jesseseay/kicad_lib/template/Hammond_1593K_Enclosure/meta/1593K3B.jpg

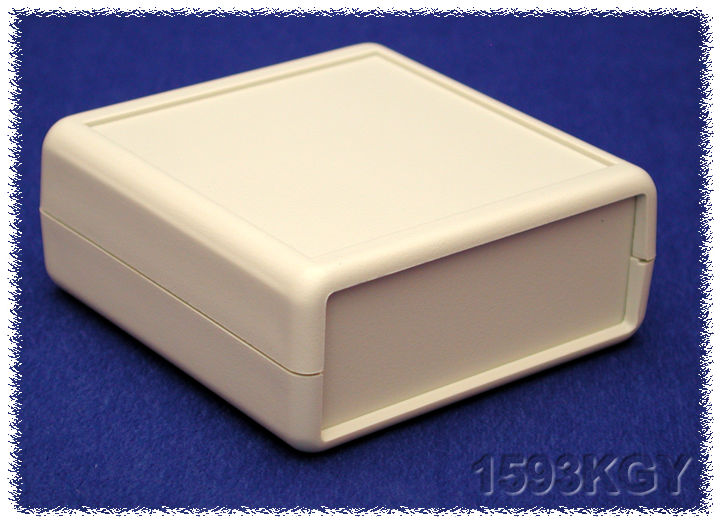
template/Hammond_1593K_Enclosure/meta/1593K3B.jpg
