jesseseay/kicad_lib/template/stm32f100-discovery-shield/meta/board_stm32vl_discovery.png

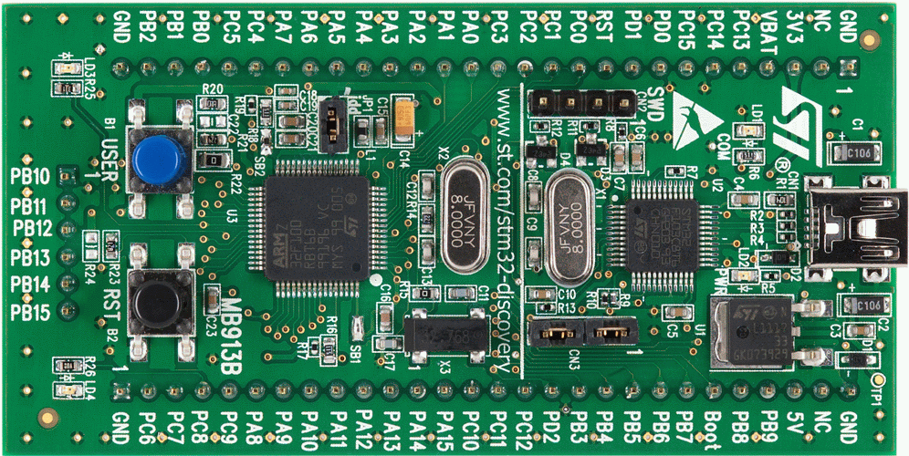
template/stm32f100-discovery-shield/meta/board_stm32vl_discovery.png
