jesseseay/kicad_lib/template/Arduino_Fio/meta/brd.png

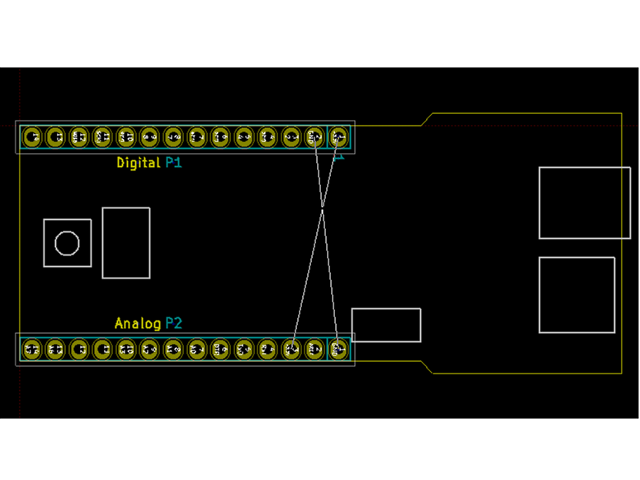
template/Arduino_Fio/meta/brd.png
