jesseseay/kicad_lib/template/Arduino_Mega_R3/meta/brd.png

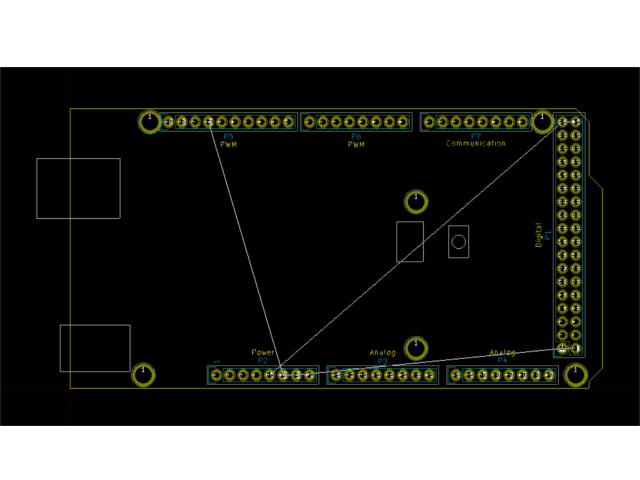
template/Arduino_Mega_R3/meta/brd.png
