jesseseay/kicad_lib/template/Arduino_Micro/meta/brd.png

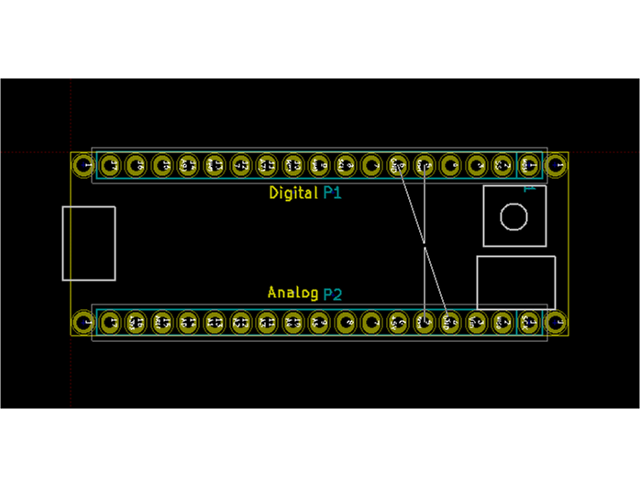
template/Arduino_Micro/meta/brd.png
