jesseseay/kicad_lib/template/Arduino_Mini/meta/brd.png

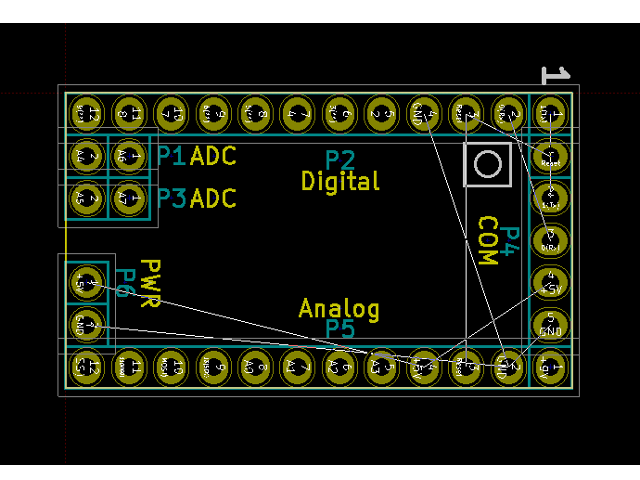
template/Arduino_Mini/meta/brd.png
