jesseseay/kicad_lib/template/Arduino_Nano/meta/brd.png

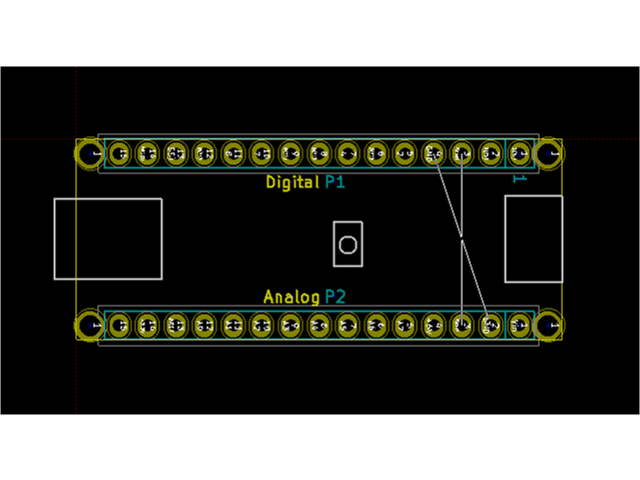
template/Arduino_Nano/meta/brd.png
