jesseseay/kicad_lib/template/Arduino_Pro_Mini/meta/brd.png

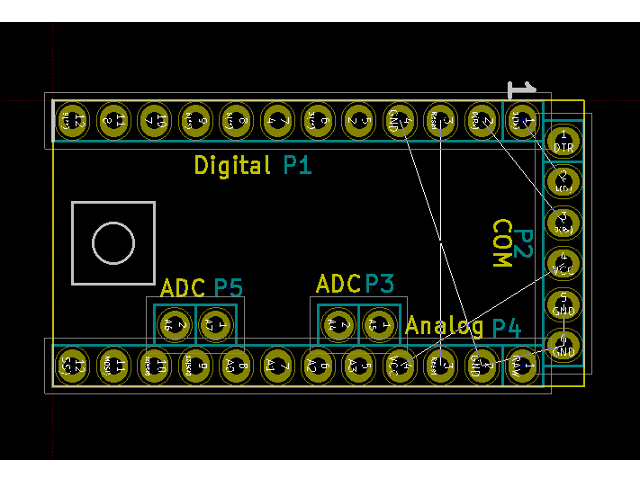
template/Arduino_Pro_Mini/meta/brd.png
