jesseseay/kicad_lib/template/BeagleBone-Black-Cape/meta/brd.png

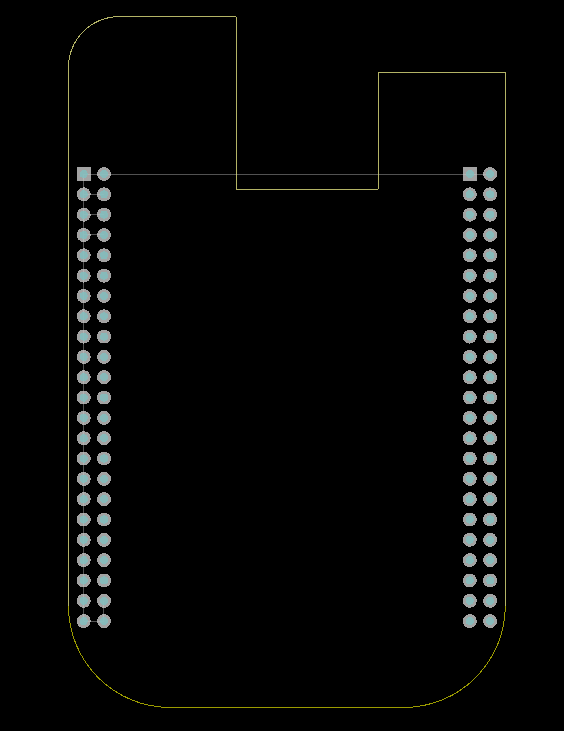
template/BeagleBone-Black-Cape/meta/brd.png
