jesseseay/kicad_lib/template/EuroCard160mmX100mm/meta/brd.png

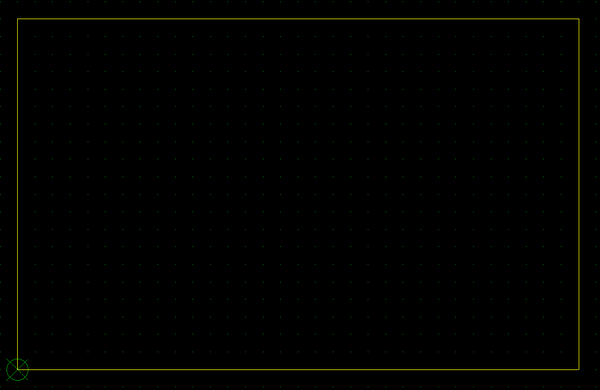
template/EuroCard160mmX100mm/meta/brd.png
