jesseseay/kicad_lib/template/Hammond_1593K_Enclosure/meta/brd.png

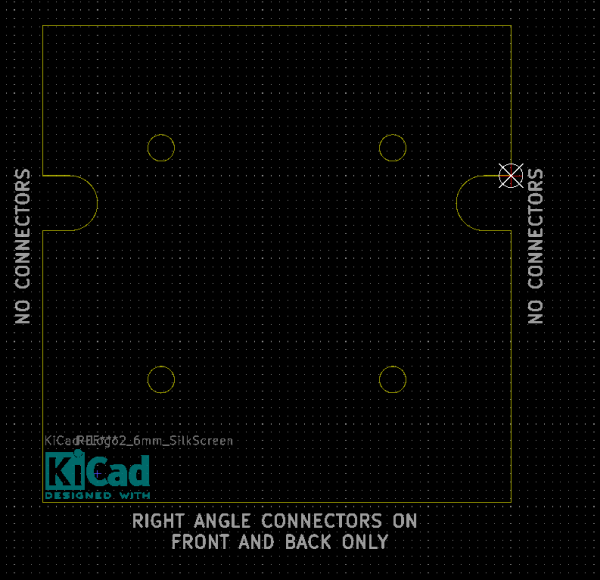
template/Hammond_1593K_Enclosure/meta/brd.png
