jesseseay/kicad_lib/template/minnowboard-ls-lure/meta/brd.png

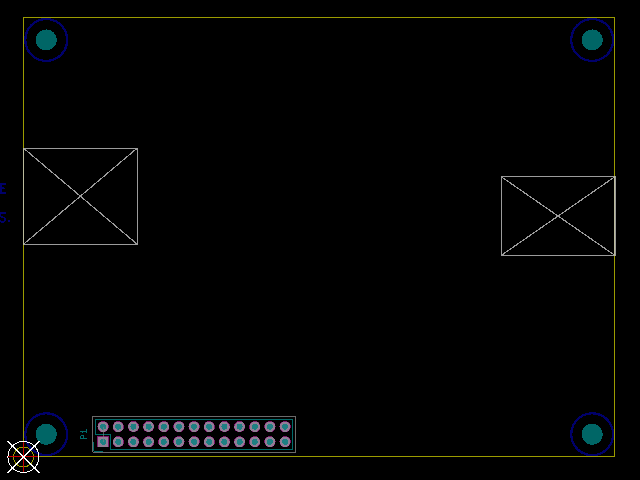
template/minnowboard-ls-lure/meta/brd.png
