jesseseay/kicad_lib/template/raspberrypi-gpio-40pin/meta/brd.png

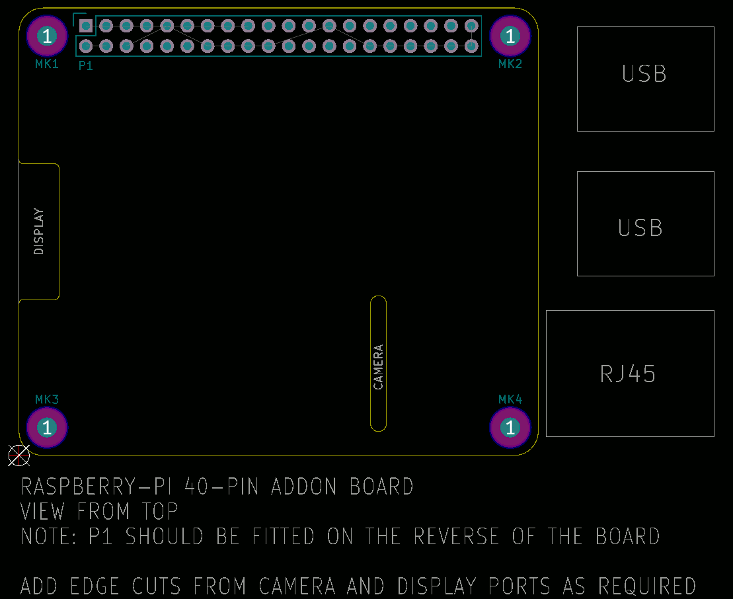
template/raspberrypi-gpio-40pin/meta/brd.png
