jesseseay/kicad_lib/template/raspberrypi-gpio/meta/brd.png

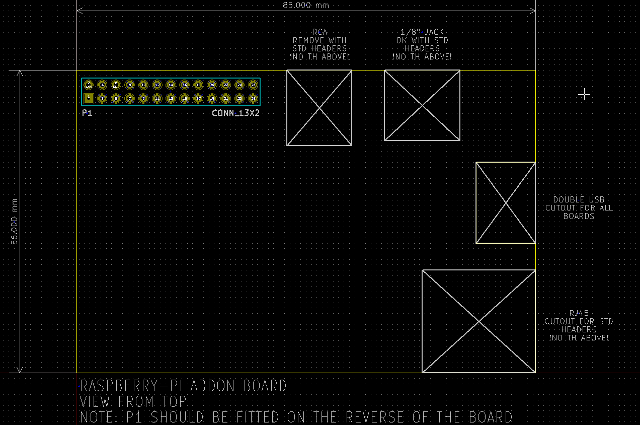
template/raspberrypi-gpio/meta/brd.png
