jesseseay/kicad_lib/template/raspberrypi_hat/meta/brd.png

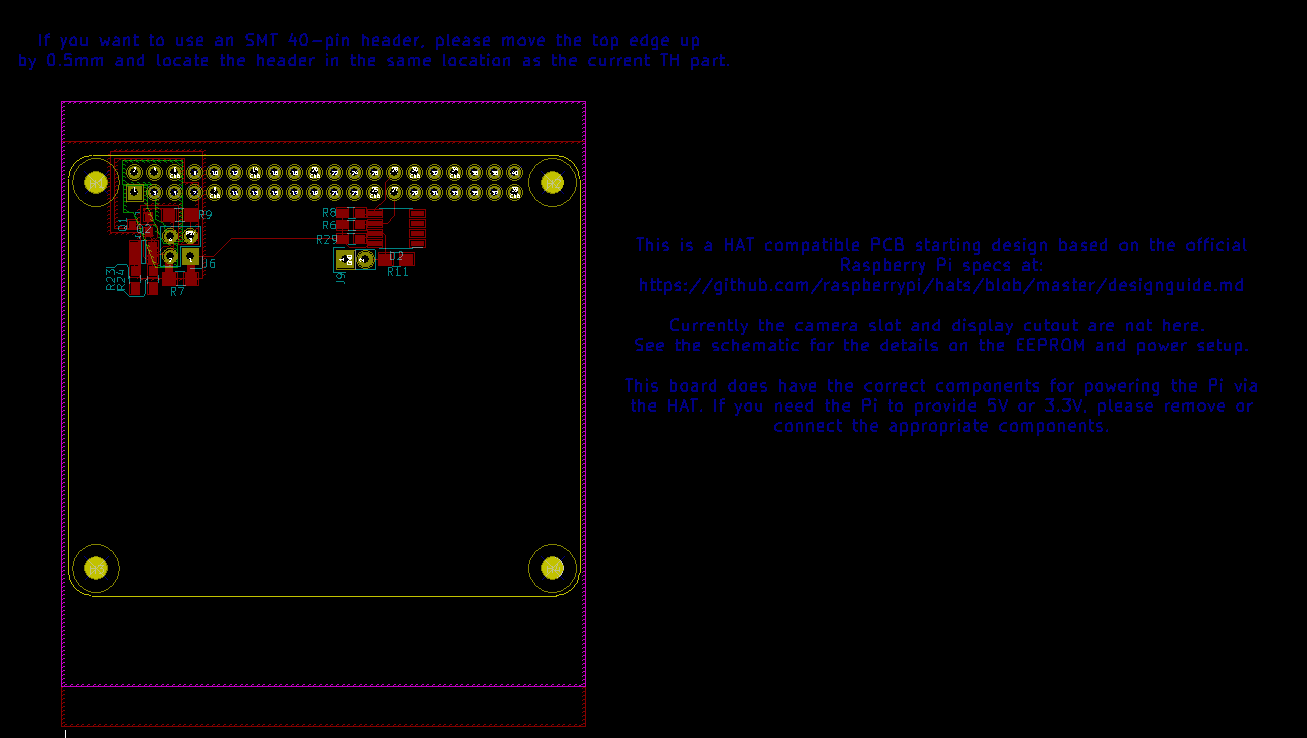
template/raspberrypi_hat/meta/brd.png
