jesseseay/kicad_lib/template/ti-stellaris-boosterpack40_min/meta/launchpad_standard40.png

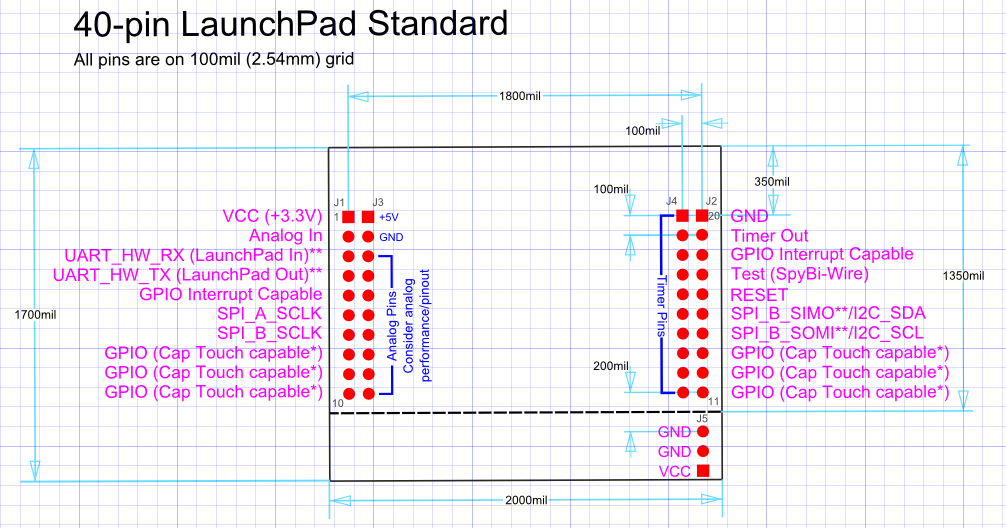
template/ti-stellaris-boosterpack40_min/meta/launchpad_standard40.png
