jesseseay/kicad_lib/Wingate kicad/demos/interf_u/tux.bmp

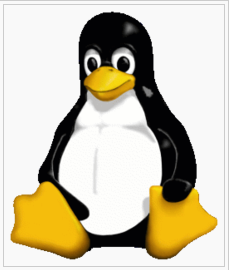
Wingate kicad/demos/interf_u/tux.bmp
