jesseseay/kicad_lib/Wingate kicad/demos/stickhub/3dmodels/APHB1608.step

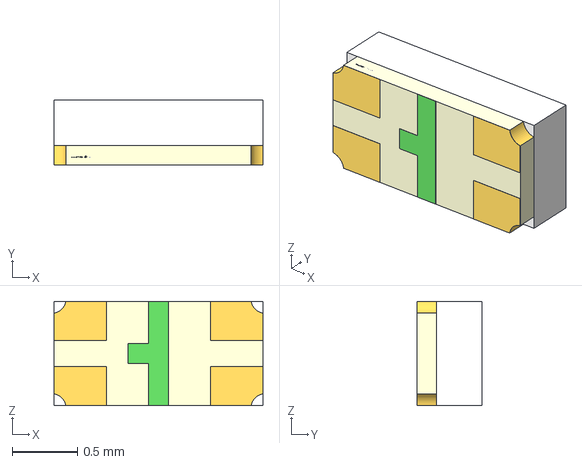
[picture p19: CAD file, 2022-09-02]
Wingate kicad/demos/stickhub/3dmodels/APHB1608.step
1.60 x 0.501 x 0.8 mm
