jesseseay/kicad_lib/Wingate kicad/demos/stickhub/3dmodels/TDFN-8_1.5x2mm_Fused-Lead_MO-252-W2015D.step

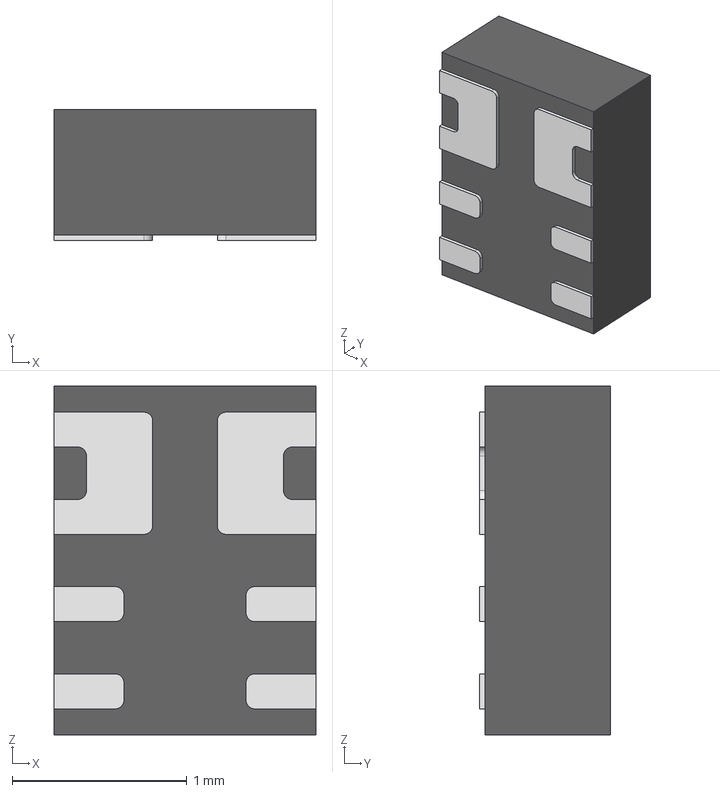
[picture p20: CAD file, 2022-09-02]
Wingate kicad/demos/stickhub/3dmodels/TDFN-8_1.5x2mm_Fused-Lead_MO-252-W2015D.step
1.50 x 0.75 x 2.00 mm
