jesseseay/kicad_lib/Wingate kicad/demos/stickhub/3dmodels/Crystal_SMD_4P_2520.step

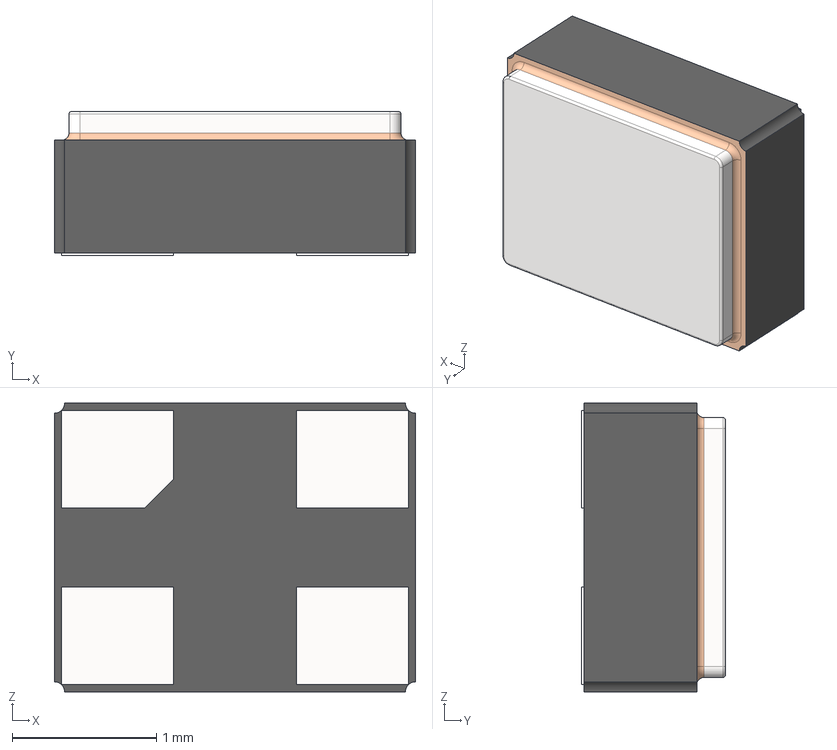
[picture p21: CAD file, 2022-09-02]
Wingate kicad/demos/stickhub/3dmodels/Crystal_SMD_4P_2520.step
2.50 x 1.00 x 2.00 mm
