jesseseay/kicad_lib/Wingate kicad/demos/stickhub/3dmodels/JST_SH_SM04B-SRSS-TB.STEP

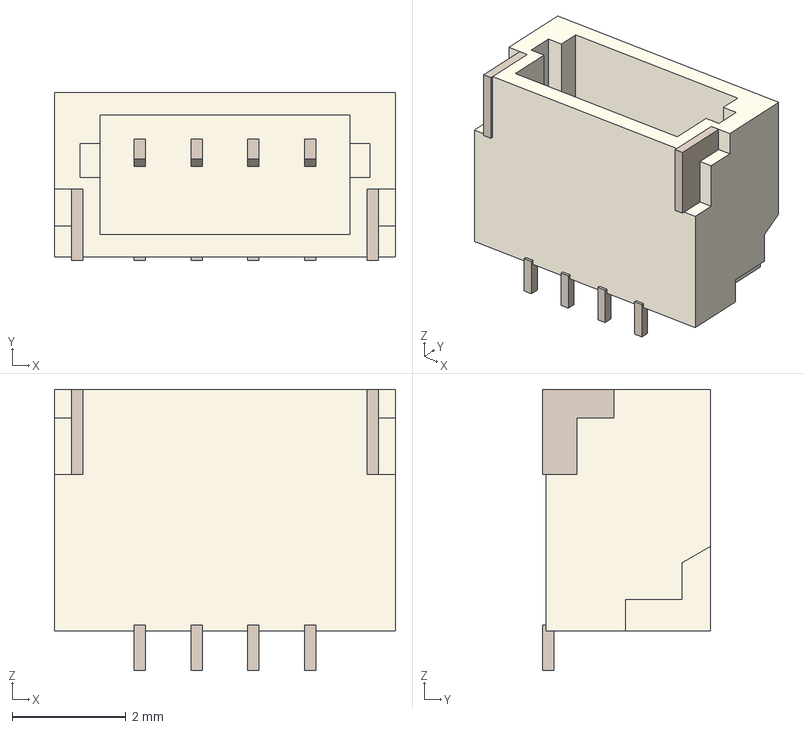
[picture p22: CAD file, 2022-09-02]
Wingate kicad/demos/stickhub/3dmodels/JST_SH_SM04B-SRSS-TB.STEP
6.00 x 2.96 x 4.95 mm
