jesseseay/kicad_lib/Wingate kicad/demos/stickhub/StickHub.kicad_pcb

## KiCad design Wingate kicad/demos/stickhub/StickHub.kicad_pcb (2022-09-02)

Schematic: StickHub.kicad_sch

Parts:
C1: 1uF 10V; 1608_C; Voltage 16V; Tolerance 10%; MPN FS15B105K100PKG
C2, C5, C6, C7, C8, C9, C10, C11, C12, C13: 0.1uF; 1608_C; Voltage 16V; Tolerance 10%; MPN CC0402KRX7R7BB104
C3, C4: 10uF 6.3V; 1608_C; Voltage 16V; Tolerance 10%; MPN CL05A106MQ5NUNC
C14, C15, C16, C17, C18, C19, C20, C21: 0.1uF 100V; 1608_C; Voltage 16V; Tolerance 10%; MPN NM0805B104K101CEDN
C22, C23, C24, C25, C26, C27, C29, C30, C31, C32, C33, C34, C35, C36, C37: 22uF 10V; 1608_C; Voltage 16V; Tolerance 10%; MPN GRM188R61A226ME15D
C28: 15nF; 1608_C; Voltage 16V; Tolerance 10%
C38: 330uF 10V; CP_Elec_6.3x7.7
D1, D2, D3, D4, D5, D6, D7, D8, D9, D10, D11, D12, D13, D14, D22, D23: TVS; 1006_C; MPN AR0521P1
D15, D16, D17, D18, D19, D20, D21: USB; Duo_LED_1.6x0.8_Kingbright_APHB1608LZGKSURKC; MPN APHB1608SGEC
D24, D25: 5V; 1006_C; MPN D5V0H1B2LP-7B
H1: Strap; Plain_Hole_3mm
J1: HOST; USB_A_PCB_traces_small
J2: USB1; JST_SH_SM04B-SRSS-TB_1x04-1MP_P1.00mm_Horizontal; MPN SM04B-SRSS-TB(LF)(SN)
J3: USB2; JST_SH_SM04B-SRSS-TB_1x04-1MP_P1.00mm_Horizontal; MPN SM04B-SRSS-TB(LF)(SN)
J4: USB3; JST_SH_SM04B-SRSS-TB_1x04-1MP_P1.00mm_Horizontal; MPN SM04B-SRSS-TB(LF)(SN)
J5: USB4; JST_SH_SM04B-SRSS-TB_1x04-1MP_P1.00mm_Horizontal; MPN SM04B-SRSS-TB(LF)(SN)
J6: USB5; JST_SH_SM04B-SRSS-TB_1x04-1MP_P1.00mm_Horizontal; MPN SM04B-SRSS-TB(LF)(SN)
J7: USB6; JST_SH_SM04B-SRSS-TB_1x04-1MP_P1.00mm_Horizontal; MPN SM04B-SRSS-TB(LF)(SN)
J8: USB7; JST_SH_SM04B-SRSS-TB_1x04-1MP_P1.00mm_Horizontal; MPN SM04B-SRSS-TB(LF)(SN)
J9: EXTGND; 1P-1.5x1.5
JP1: EXTPWR; PinHeader_1x02_P2.54mm_Vertical
LOGO1, LOGO2, LOGO3, LOGO4: Logo
R1: 10k; 1608_C; MPN 0402WGF1002TCE
R2, R3, R4, R5: 100k; 1608_C; MPN 0402WGF1003TCE
R6: 2.7k; 1608_C; MPN 0402WGF2701TCE
R7, R8, R9, R10, R11, R12, R13: 470; 1608_C; MPN 0402WGF4700TCE
U1: MaxLinear_XR22417-48; LQFP-48_7x7mm_P0.5mm; MPN XR22417CV48TR-F
U2: Dialog_SLG5NT1487V; TDFN-8_1.5x2mm_Fused-Lead_JEDEC_MO-252_W2015D; MPN SLG5NT1487VTR
Y1: 12MHz 50ppm 16-20pF; Crystal_4-SMD_2.5x2mm; MPN CM4012M00020T8188026

Connections:
+1V8: C4.1, C11.1, C12.1, C13.1, U1.6 (VCC18), U1.21 (VCC18), U1.25 (1V8_OUT), U1.28 (VCC18)
+3V3: C3.1, C5.1, C6.1, C7.1, C8.1, C9.1, C10.1, R3.1, R4.1, R5.1, U1.9 (3V3_OUT), U1.15 (VCC33), U1.20 (VCC33), U1.26 (VCC33), U1.31 (VCC33), U1.36 (VCC33), U1.42 (VCC33)
+5V: C1.1, C14.1, C15.1, C16.1, C17.1, C18.1, C19.1, C20.1, C22.1, C23.1, C24.1, C25.1, C26.1, C27.1, C29.1, C30.1, C31.1, C32.1, C33.1, C34.1, C35.1, C36.1, C37.1, C38.1 (+), D25.2 (A2), J2.1, J3.1, J4.1, J5.1, J6.1, J7.1, J8.1, R1.1, U1.8 (VCC5), U2.5 (S)
/D+: D23.2 (A2), J1.3, U1.30 (UP_D+)
/D-: D22.2 (A2), J1.2, U1.29 (UP_D-)
/LC: D15.GK (2), D15.RA (3), D16.GK (2), D16.RA (3), D17.GK (2), D17.RA (3), D18.GK (2), D18.RA (3), D19.GK (2), D19.RA (3), D20.GK (2), D20.RA (3), D21.GK (2), D21.RA (3), U1.1 (LED_CTL)
/LED1: R7.2, U1.3 (LED1/SCL)
/LED2: R8.2, U1.4 (LED2)
/LED3: R9.2, U1.5 (LED3)
/LED4: R10.2, U1.7 (LED4)
/LED5: R11.2, U1.48 (LED5)
/LED6: R12.2, U1.47 (LED6)
/LED7: R13.2, U1.46 (LED7)
/U1D+: D2.2 (A2), J2.3, U1.19 (USB1D+)
/U1D-: D1.2 (A2), J2.2, U1.18 (USB1D-)
/U2D+: D4.2 (A2), J3.3, U1.17 (USB2D+)
/U2D-: D3.2 (A2), J3.2, U1.16 (USB2D-)
/U3D+: D6.2 (A2), J4.3, U1.14 (USB3D+)
/U3D-: D5.2 (A2), J4.2, U1.13 (USB3D-)
/U4D+: D8.2 (A2), J5.3, U1.12 (USB4D+)
/U4D-: D7.2 (A2), J5.2, U1.11 (USB4D-)
/U5D+: D10.2 (A2), J6.3, U1.33 (USB5D+)
/U5D-: D9.2 (A2), J6.2, U1.32 (USB5D-)
/U6D+: D12.2 (A2), J7.3, U1.35 (USB6D+)
/U6D-: D11.2 (A2), J7.2, U1.34 (USB6D-)
/U7D+: D14.2 (A2), J8.3, U1.38 (USB7D+)
/U7D-: D13.2 (A2), J8.2, U1.37 (USB7D-)
/XI: U1.22 (XTALIN), Y1.1
/XO: U1.23 (XTALOUT), Y1.3
GND: C1.2, C2.2, C3.2, C4.2, C5.2, C6.2, C7.2, C8.2, C9.2, C10.2, C11.2, C12.2, C13.2, C14.2, C15.2, C16.2, C17.2, C18.2, C19.2, C20.2, C21.2, C22.2, C23.2, C24.2, C25.2, C26.2, C27.2, C28.2, C29.2, C30.2, C31.2, C32.2, C33.2, C34.2, C35.2, C36.2, C37.2, C38.2 (-), D1.1 (A1), D2.1 (A1), D3.1 (A1), D4.1 (A1), D5.1 (A1), D6.1 (A1), D7.1 (A1), D8.1 (A1), D9.1 (A1), D10.1 (A1), D11.1 (A1), D12.1 (A1), D13.1 (A1), D14.1 (A1), D22.1 (A1), D23.1 (A1), D24.1 (A1), D25.1 (A1), J1.4, J2.4, J2.MP (MountPin), J3.4, J3.MP (MountPin), J4.4, J4.MP (MountPin), J5.4, J5.MP (MountPin), J6.4, J6.MP (MountPin), J7.4, J7.MP (MountPin), J8.4, J8.MP (MountPin), J9.1, R2.2, R6.2, U1.10 (GND), U1.24 (GND), U1.39 (GND), U2.8 (GND), Y1.2 (GND), Y1.4 (GND)
unnamed: C2.1, R1.2, R2.1, U1.41 (VBUS_SENSE)
unnamed: C28.1, U2.7 (CAP)
unnamed: D15.GA (1), D15.RK (4), R7.1
unnamed: D16.GA (1), D16.RK (4), R8.1
unnamed: D17.GA (1), D17.RK (4), R9.1
unnamed: D18.GA (1), D18.RK (4), R10.1
unnamed: D19.GA (1), D19.RK (4), R11.1
unnamed: D20.GA (1), D20.RK (4), R12.1
unnamed: D21.GA (1), D21.RK (4), R13.1
unnamed: J1.1, JP1.1
unnamed: R3.2, U1.40 (EXT_RST#)
unnamed: R4.2, U1.45 (TEST3#)
unnamed: R5.2, U1.43 (TEST1#)
unnamed: R6.1, U1.27 (REXT)
VIN: C21.1, D24.2 (A2), JP1.2, U2.1 (VDD), U2.2 (ON), U2.3 (D)

Notes on the sheet:
ESD caps at connectors / plug
Shared VBUS capacitance

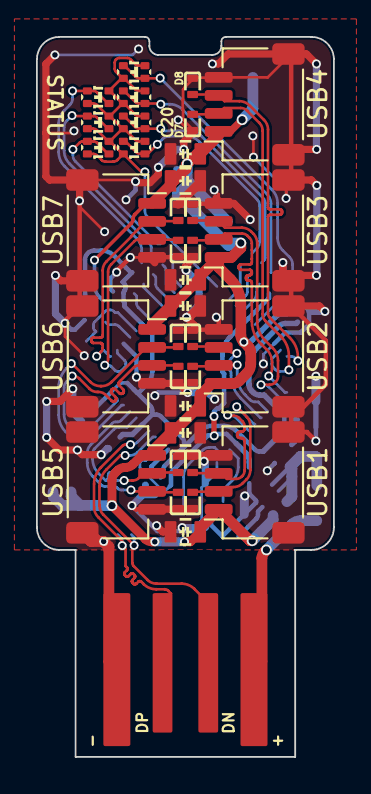
[picture p28: board StickHub.kicad_pcb from above]

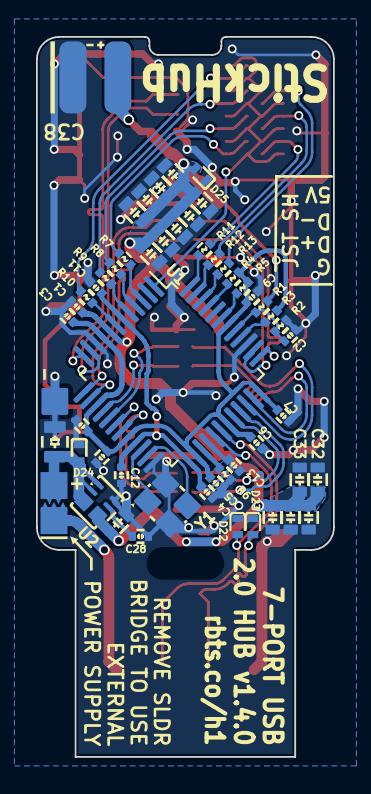
[picture p29: board StickHub.kicad_pcb from below]

Board: 2 copper layers, 16.5 x 40.0 mm, 94 parts (57 on the bottom side), 45 nets.
