jesseseay/kicad_lib/Wingate kicad/demos/test_xil_95108/carte_test.kicad_pcb

## KiCad design Wingate kicad/demos/test_xil_95108/carte_test.kicad_pcb (2022-09-02)

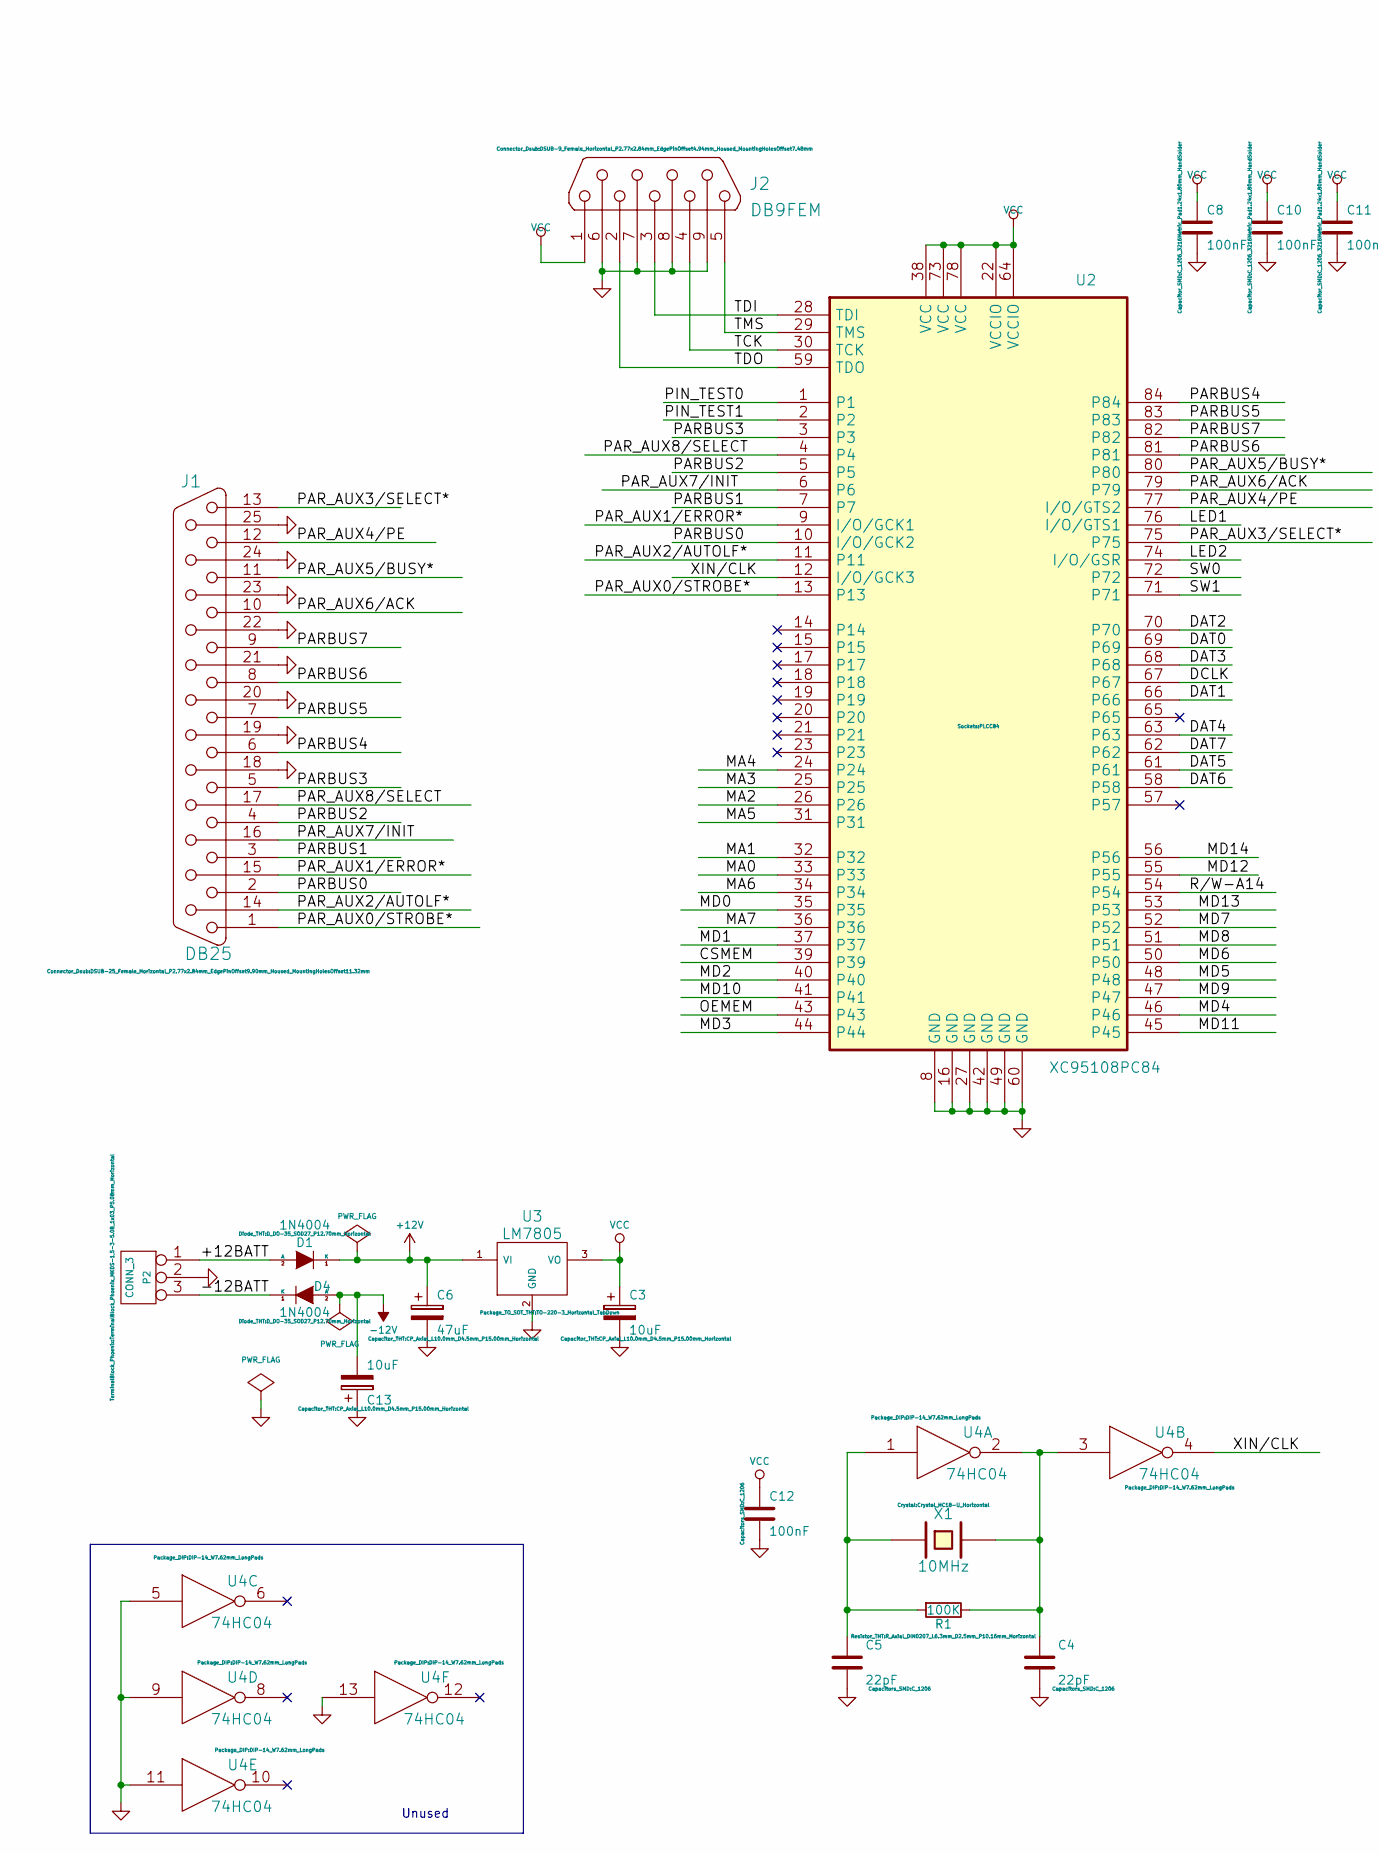
[picture p30: schematic carte_test.kicad_sch, XC95108PC84 EXPERIMENTATION BOARD, part in row 1, column 1]

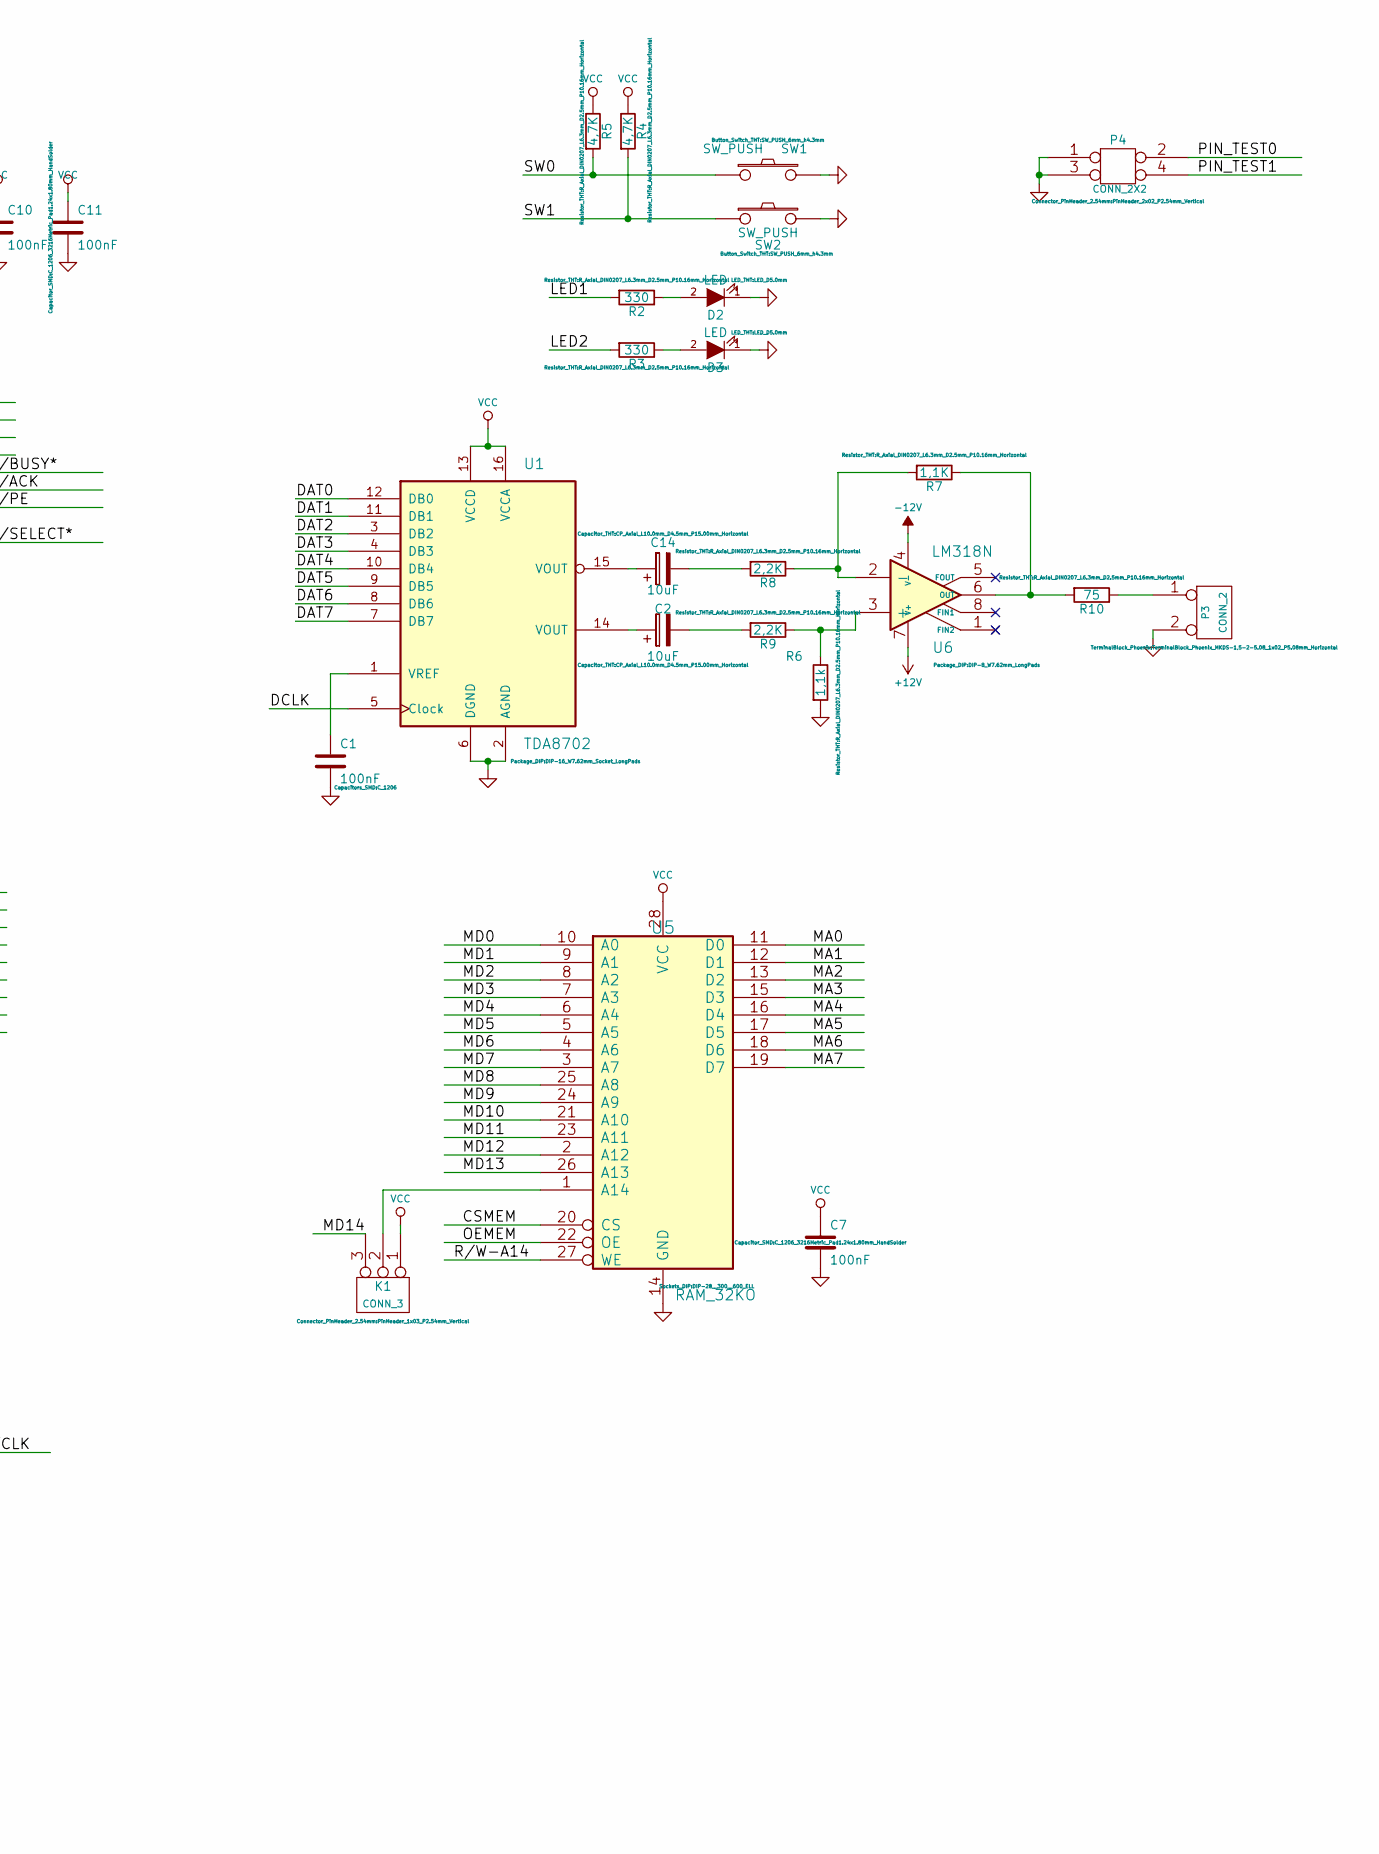
[picture p31: schematic carte_test.kicad_sch, XC95108PC84 EXPERIMENTATION BOARD, part in row 1, column 2]

Parts:
C1, C12: 100nF; C_1206
C2, C3, C13, C14: 10uF; CP_Axial_L10.0mm_D4.5mm_P15.00mm_Horizontal
C4, C5: 22pF; C_1206
C6: 47uF; CP_Axial_L10.0mm_D4.5mm_P15.00mm_Horizontal
C7, C8, C10, C11: 100nF; C_1206_3216Metric_Pad1.24x1.80mm_HandSolder
D1, D4: 1N4004; D_DO-35_SOD27_P12.70mm_Horizontal
D2, D3: LED; LED_D5.0mm
J1: DB25; DSUB-25_Female_Horizontal_P2.77x2.84mm_EdgePinOffset9.90mm_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
J2: DB9FEM; DSUB-9_Female_Horizontal_P2.77x2.84mm_EdgePinOffset4.94mm_H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
K1: CONN_3; PinHeader_1x03_P2.54mm_Vertical
P2: CONN_3; TerminalBlock_Phoenix_MKDS-1,5-3-5.08_1x03_P5.08mm_Horizont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
P3: CONN_2; TerminalBlock_Phoenix_MKDS-1,5-2-5.08_1x02_P5.08mm_Horizont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
P4: CONN_2X2; PinHeader_2x02_P2.54mm_Vertical
R1: 100K; R_Axial_DIN0207_L6.3mm_D2.5mm_P10.16mm_Horizontal
R2, R3: 330; R_Axial_DIN0207_L6.3mm_D2.5mm_P10.16mm_Horizontal
R4, R5: 4,7K; R_Axial_DIN0207_L6.3mm_D2.5mm_P10.16mm_Horizontal
R6: 1,1k; R_Axial_DIN0207_L6.3mm_D2.5mm_P10.16mm_Horizontal
R7: 1,1K; R_Axial_DIN0207_L6.3mm_D2.5mm_P10.16mm_Horizontal
R8, R9: 2,2K; R_Axial_DIN0207_L6.3mm_D2.5mm_P10.16mm_Horizontal
R10: 75; R_Axial_DIN0207_L6.3mm_D2.5mm_P10.16mm_Horizontal
SW1, SW2: SW_PUSH; SW_PUSH_6mm_h4.3mm
U1: TDA8702; DIP-16_W7.62mm_Socket_LongPads
U2: XC95108PC84; PLCC84
U3: LM7805; TO-220-3_Horizontal_TabDown
U4: 74HC04; DIP-14_W7.62mm_LongPads
U5: RAM_32KO; DIP-28__300__600_ELL
U6: LM318N; DIP-8_W7.62mm_LongPads
X1: 10MHz; Crystal_HC18-U_Horizontal

Connections:
+12V: C6.1, D1.1 (K), U3.1 (VI), U6.7 (V+)
-12V: C13.2, D4.2 (A), U6.4 (V-)
/+12BATT: D1.2 (A), P2.1
/-12BATT: D4.1 (K), P2.3
/CSMEM: U2.39, U5.20 (CS)
/DAT0: U1.12 (DB0), U2.69
/DAT1: U1.11 (DB1), U2.66
/DAT2: U1.3 (DB2), U2.70
/DAT3: U1.4 (DB3), U2.68
/DAT4: U1.10 (DB4), U2.63
/DAT5: U1.9 (DB5), U2.61
/DAT6: U1.8 (DB6), U2.58
/DAT7: U1.7 (DB7), U2.62
/DCLK: U1.5 (Clock), U2.67
/LED1: R2.2, U2.76 (I/O/GTS1)
/LED2: R3.2, U2.74 (I/O/GSR)
/MA0: U2.33, U5.11 (D0)
/MA1: U2.32, U5.12 (D1)
/MA2: U2.26, U5.13 (D2)
/MA3: U2.25, U5.15 (D3)
/MA4: U2.24, U5.16 (D4)
/MA5: U2.31, U5.17 (D5)
/MA6: U2.34, U5.18 (D6)
/MA7: U2.36, U5.19 (D7)
/MD0: U2.35, U5.10 (A0)
/MD1: U2.37, U5.9 (A1)
/MD2: U2.40, U5.8 (A2)
/MD3: U2.44, U5.7 (A3)
/MD4: U2.46, U5.6 (A4)
/MD5: U2.48, U5.5 (A5)
/MD6: U2.50, U5.4 (A6)
/MD7: U2.52, U5.3 (A7)
/MD8: U2.51, U5.25 (A8)
/MD9: U2.47, U5.24 (A9)
/MD10: U2.41, U5.21 (A10)
/MD11: U2.45, U5.23 (A11)
/MD12: U2.55, U5.2 (A12)
/MD13: U2.53, U5.26 (A13)
/MD14: K1.3, U2.56
/OEMEM: U2.43, U5.22 (OE)
/PARBUS0: J1.2, U2.10 (I/O/GCK2)
/PARBUS1: J1.3, U2.7
/PARBUS2: J1.4, U2.5
/PARBUS3: J1.5, U2.3
/PARBUS4: J1.6, U2.84
/PARBUS5: J1.7, U2.83
/PARBUS6: J1.8, U2.81
/PARBUS7: J1.9, U2.82
/PAR_AUX0/STROBE*: J1.1, U2.13
/PAR_AUX1/ERROR*: J1.15, U2.9 (I/O/GCK1)
/PAR_AUX2/AUTOLF*: J1.14, U2.11
/PAR_AUX3/SELECT*: J1.13, U2.75
/PAR_AUX4/PE: J1.12, U2.77 (I/O/GTS2)
/PAR_AUX5/BUSY*: J1.11, U2.80
/PAR_AUX6/ACK: J1.10, U2.79
/PAR_AUX7/INIT: J1.16, U2.6
/PAR_AUX8/SELECT: J1.17, U2.4
/PIN_TEST0: P4.2, U2.1
/PIN_TEST1: P4.4, U2.2
/R/W-A14: U2.54, U5.27 (WE)
/SW0: R5.2, SW1.1, U2.72
/SW1: R4.2, SW2.1, U2.71
/TCK: J2.4, U2.30 (TCK)
/TDI: J2.3, U2.28 (TDI)
/TDO: J2.2, U2.59 (TDO)
/TMS: J2.5, U2.29 (TMS)
/XIN/CLK: U2.12 (I/O/GCK3), U4.4
GND: C1.2, C3.2, C4.2, C5.2, C6.2, C7.2, C8.2, C10.2, C11.2, C12.2, C13.1, D2.1 (K), D3.1 (K), J1.18, J1.19, J1.20, J1.21, J1.22, J1.23, J1.24, J1.25, J2.6, J2.7, J2.8, J2.9, P2.2 (PM), P3.2 (PM), P4.1, P4.3, R6.2, SW1.2, SW2.2, U1.2 (AGND), U1.6 (DGND), U2.8 (GND), U2.16 (GND), U2.27 (GND), U2.42 (GND), U2.49 (GND), U2.60 (GND), U3.2 (GND), U4.5, U4.7 (GND), U4.9, U4.11, U4.13, U5.14 (GND)
unnamed: C1.1, U1.1 (VREF)
unnamed: C2.1, U1.14 (VOUT)
unnamed: C2.2, R9.2
unnamed: C4.1, R1.1, U4.2, U4.3, X1.2
unnamed: C5.1, R1.2, U4.1, X1.1
unnamed: C14.1, U1.15 (VOUT)
unnamed: C14.2, R8.2
unnamed: D2.2 (A), R2.1
unnamed: D3.2 (A), R3.1
unnamed: K1.2 (PM), U5.1 (A14)
unnamed: P3.1, R10.1
unnamed: R6.1, R9.1, U6.3 (+)
unnamed: R7.2, R8.1, U6.2 (-)
unnamed: R7.1, R10.2, U6.6 (OUT)
VCC: C3.1, C7.1, C8.1, C10.1, C11.1, C12.1, J2.1, K1.1, R4.1, R5.1, U1.13 (VCCD), U1.16 (VCCA), U2.22 (VCCIO), U2.38 (VCC), U2.64 (VCCIO), U2.73 (VCC), U2.78 (VCC), U3.3 (VO), U4.14 (VCC), U5.28 (VCC)

Notes on the sheet:
Unused

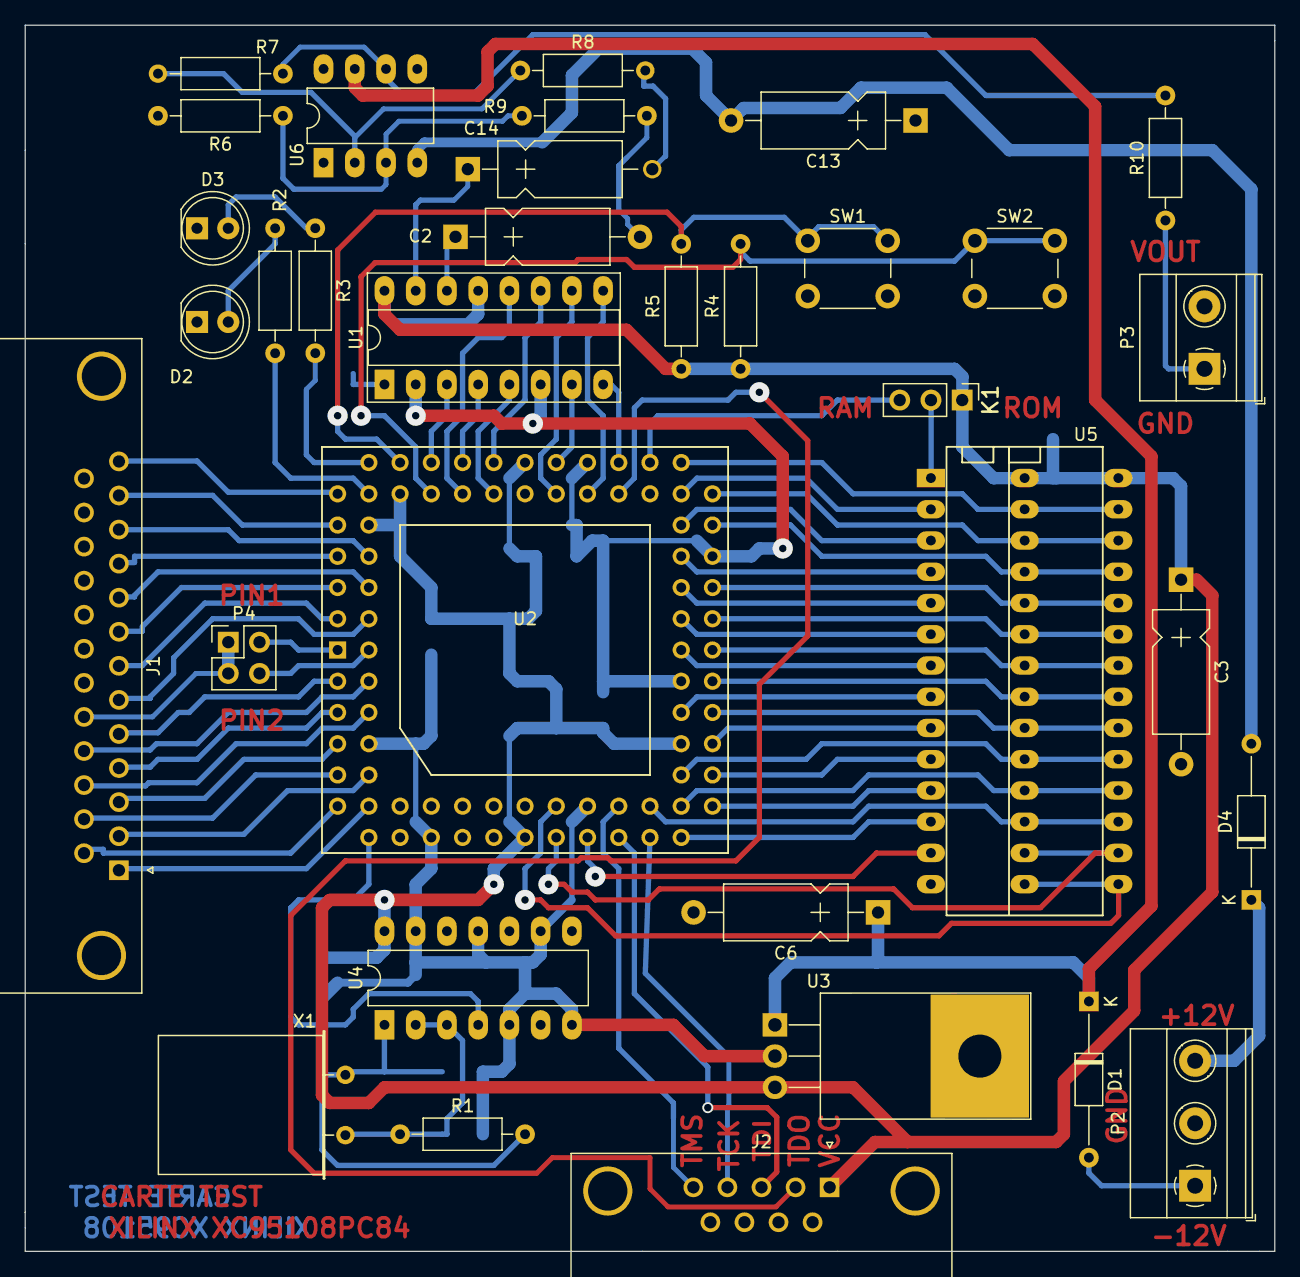
[picture p32: board carte_test.kicad_pcb from above]

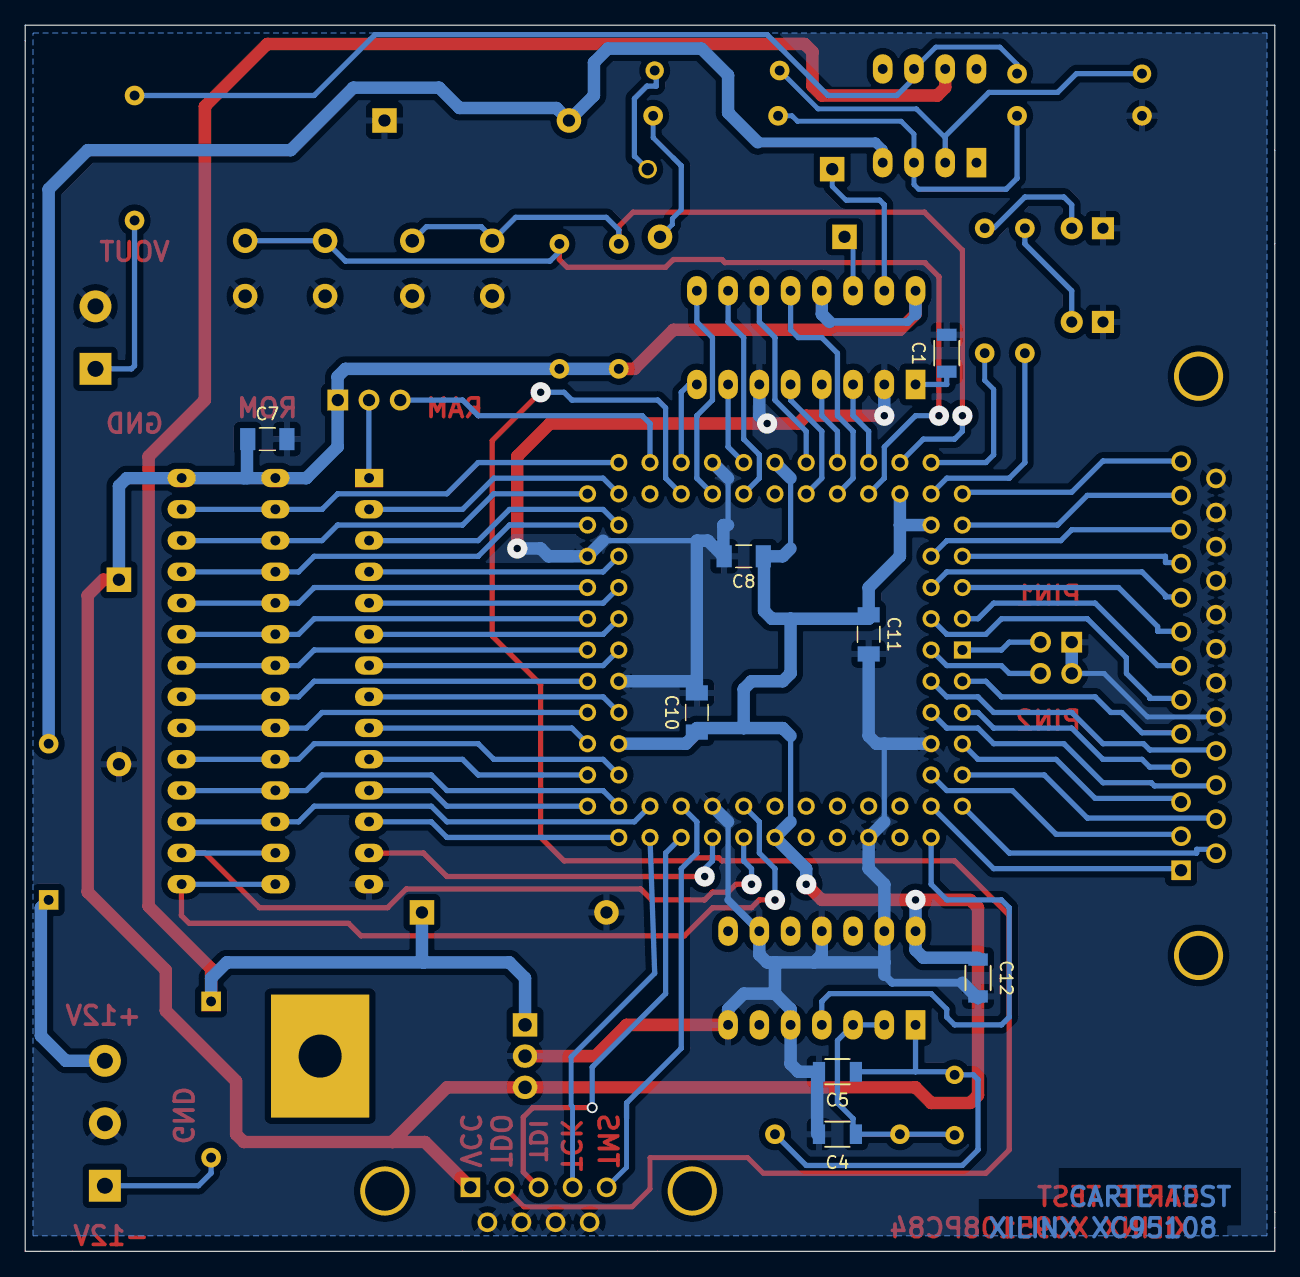
[picture p33: board carte_test.kicad_pcb from below]

Board: 2 copper layers, 101.6 x 99.7 mm, 42 parts (8 on the bottom side), 83 nets.
