jesseseay/kicad_lib/Wingate kicad/demos/ecc83/ecc83-pp_v2.kicad_pcb

## KiCad design Wingate kicad/demos/ecc83/ecc83-pp_v2.kicad_pcb (2022-09-02)

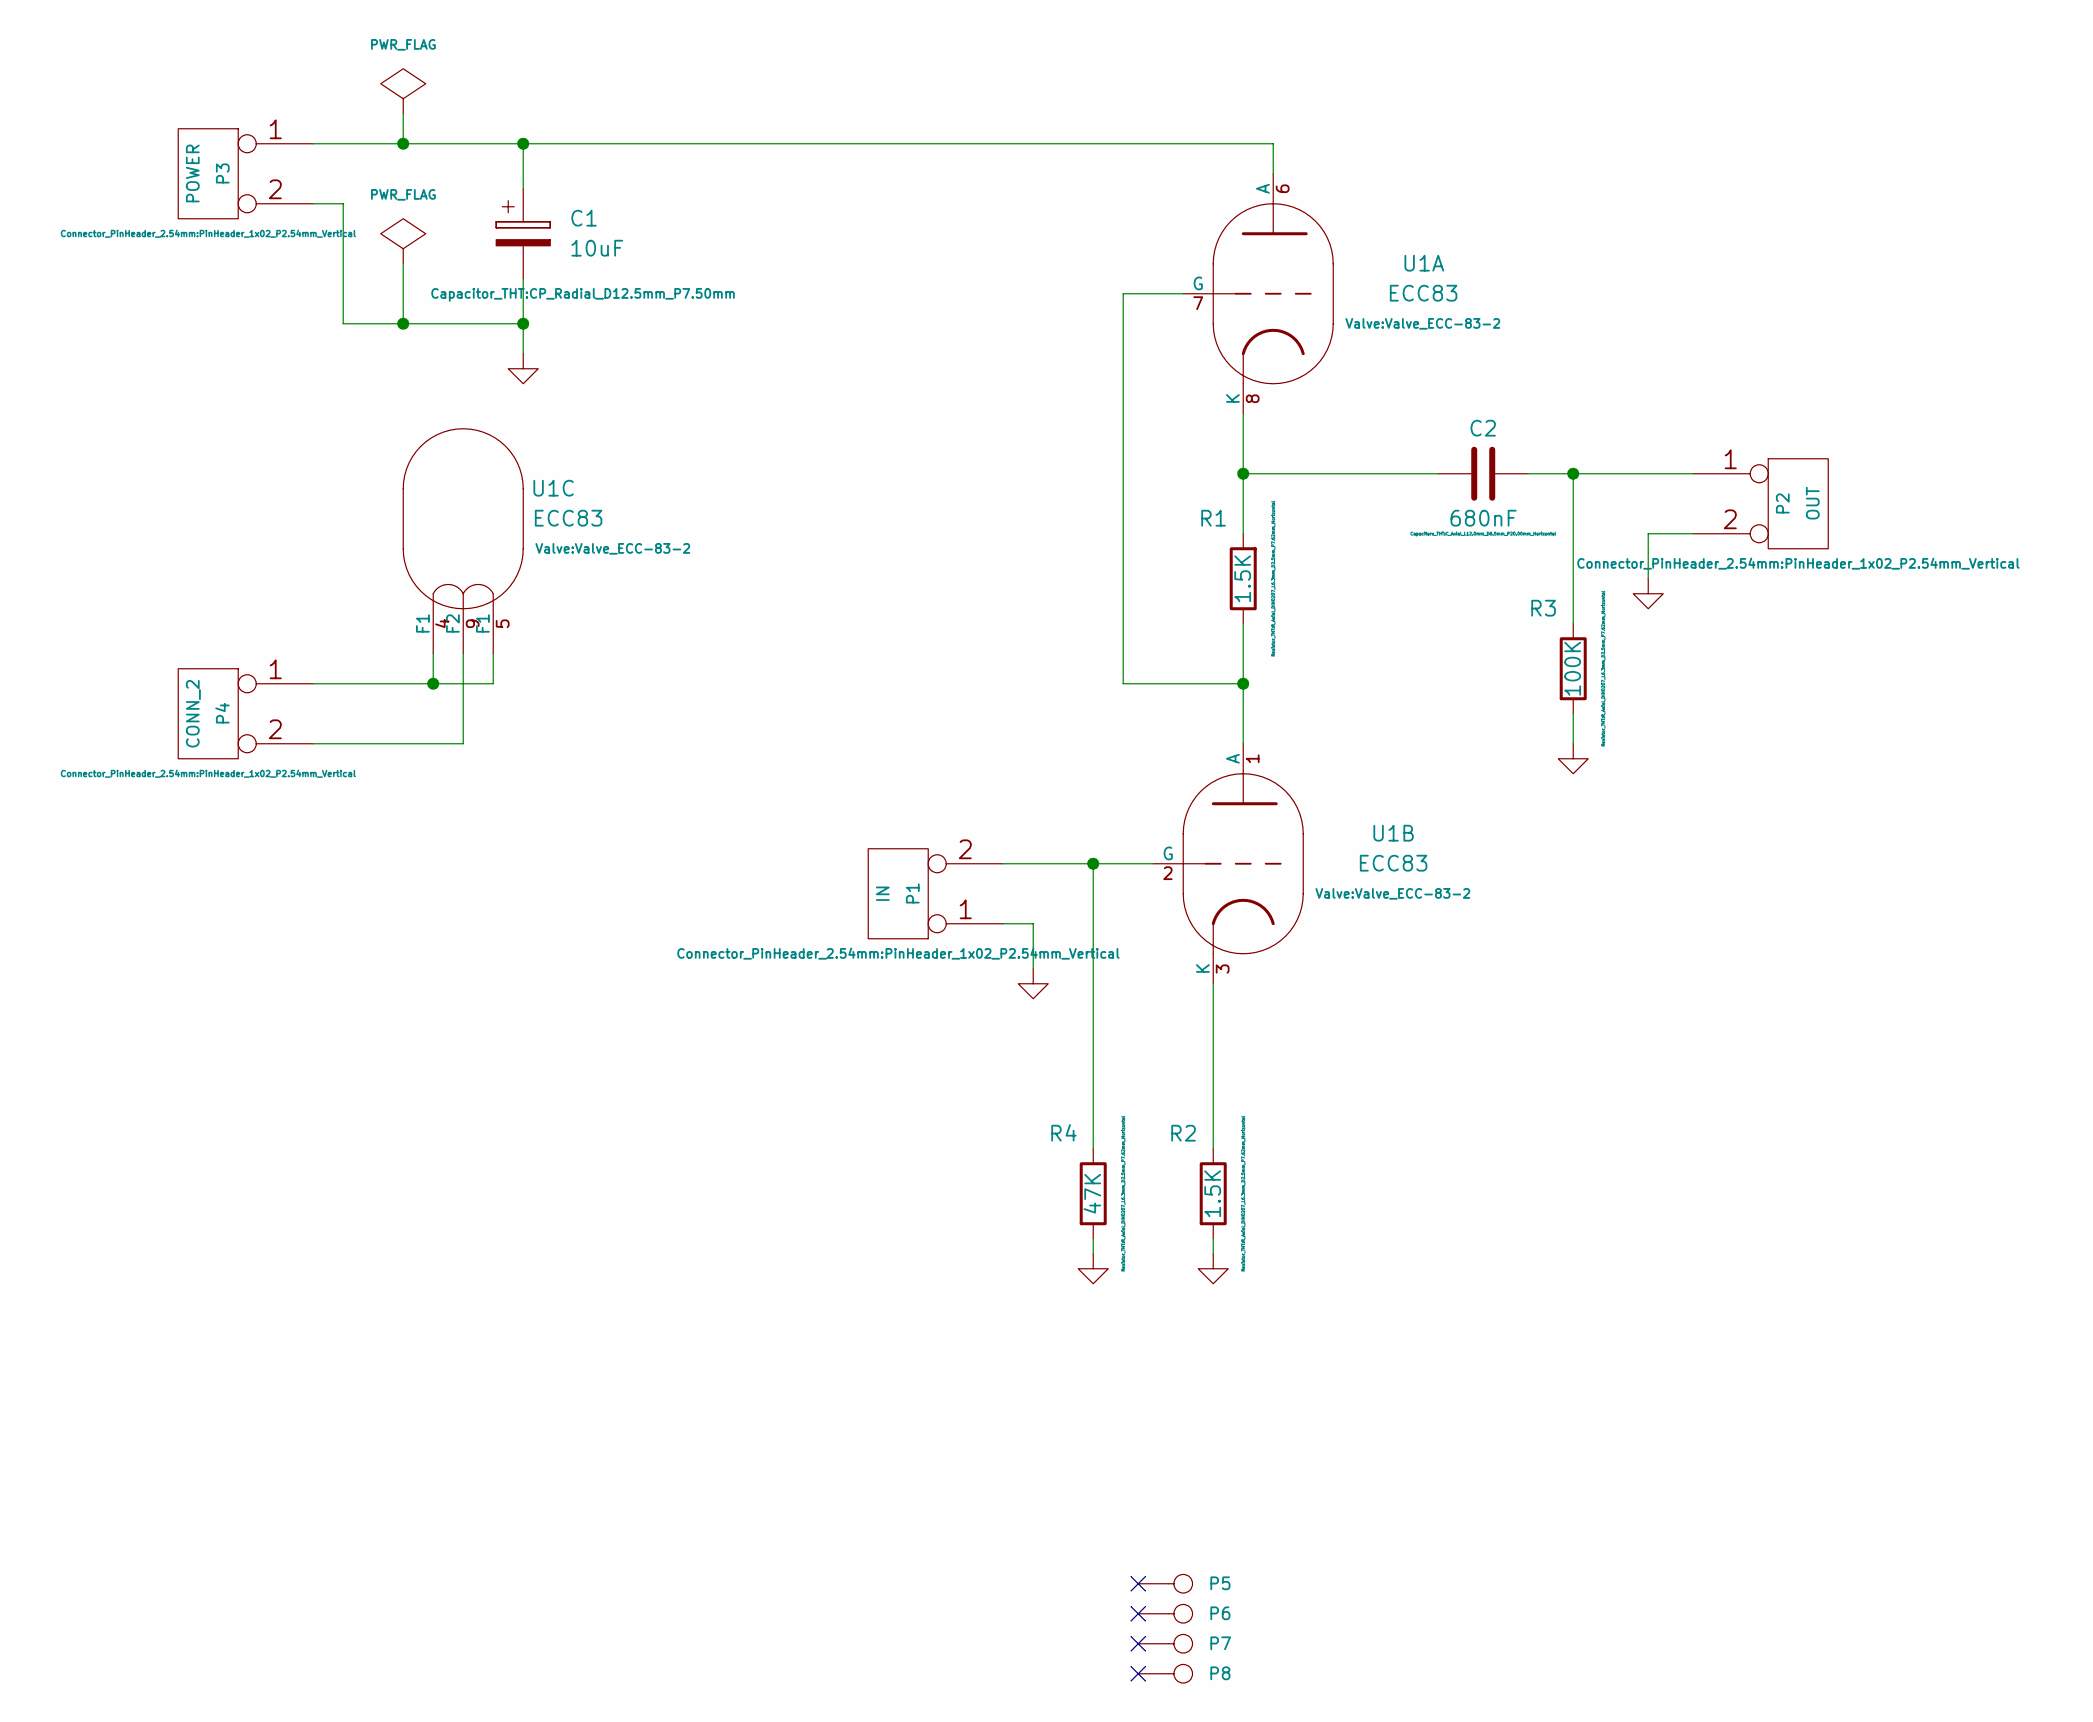
[picture p34: schematic ecc83-pp_v2.kicad_sch, ECC Push-Pull]

Parts:
C1: 10uF; CP_Radial_D12.5mm_P7.50mm
C2: 680nF; C_Axial_L12.0mm_D6.5mm_P20.00mm_Horizontal
P1: IN; PinHeader_1x02_P2.54mm_Vertical
P2: OUT; PinHeader_1x02_P2.54mm_Vertical
P3: POWER; PinHeader_1x02_P2.54mm_Vertical
P4: CONN_2; PinHeader_1x02_P2.54mm_Vertical
P5, P6, P7, P8: CONN_1; 1pin
R1, R2: 1.5K; R_Axial_DIN0207_L6.3mm_D2.5mm_P7.62mm_Horizontal
R3: 100K; R_Axial_DIN0207_L6.3mm_D2.5mm_P7.62mm_Horizontal
R4: 47K; R_Axial_DIN0207_L6.3mm_D2.5mm_P7.62mm_Horizontal
U1: ECC83; Valve_ECC-83-2

Connections:
GND: C1.2, P1.1, P2.2 (PM), P3.2 (PM), R2.2, R3.2, R4.2
unnamed: C1.1, P3.1, U1.6 (A)
unnamed: C2.1, P2.1, R3.1
unnamed: C2.2, R1.2, U1.8 (K)
unnamed: P1.2 (PM), R4.1, U1.2 (G)
unnamed: P4.1, U1.4 (F1), U1.5 (F1)
unnamed: P4.2 (PM), U1.9 (F2)
unnamed: R1.1, U1.1 (A), U1.7 (G)
unnamed: R2.1, U1.3 (K)

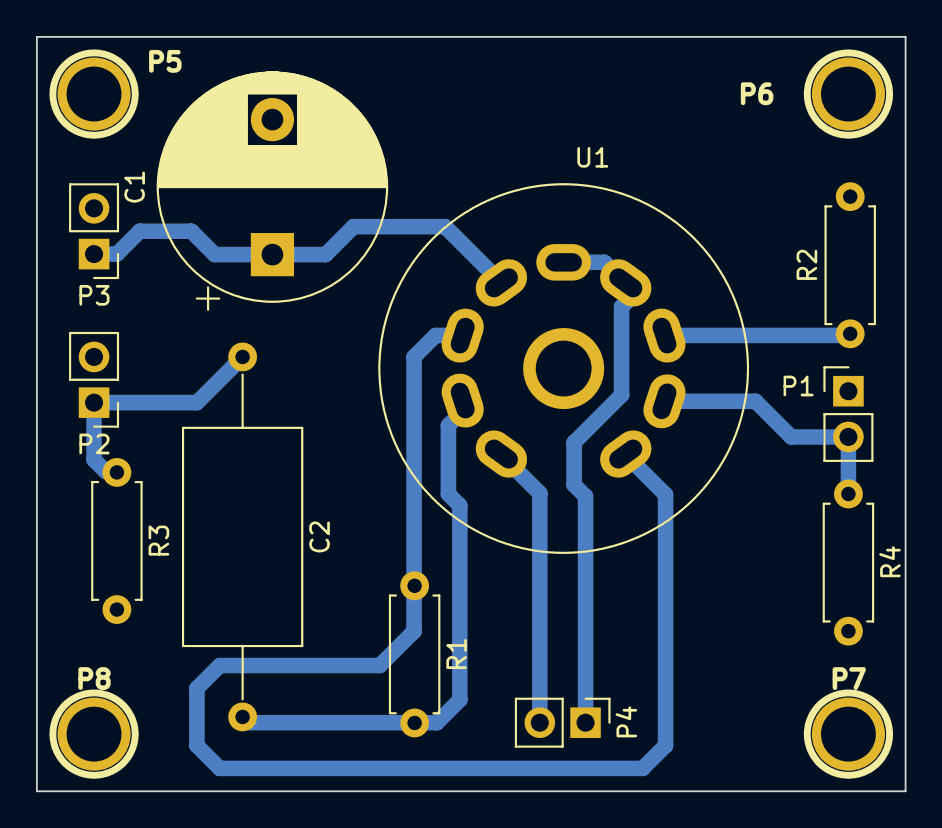
[picture p35: board ecc83-pp_v2.kicad_pcb from above]

Board: 2 copper layers, 48.3 x 41.9 mm, 15 parts (0 on the bottom side), 9 nets.
