jesseseay/kicad_lib/Wingate kicad/demos/test_pads_inside_pads/test_pads_inside_pads.kicad_pcb

## KiCad design Wingate kicad/demos/test_pads_inside_pads/test_pads_inside_pads.kicad_pcb (2022-09-02)

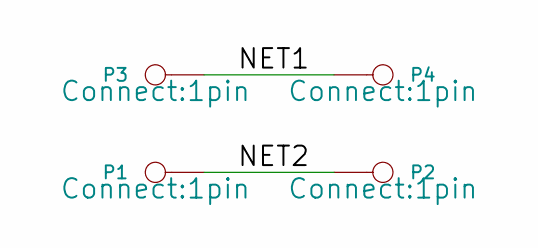
[picture p38: schematic test_pads_inside_pads.kicad_sch]

Parts:
P1, P2, P3, P4: CONN_1; 1pin

Connections:
/NET1: P3.1, P4.1
/NET2: P1.1, P2.1

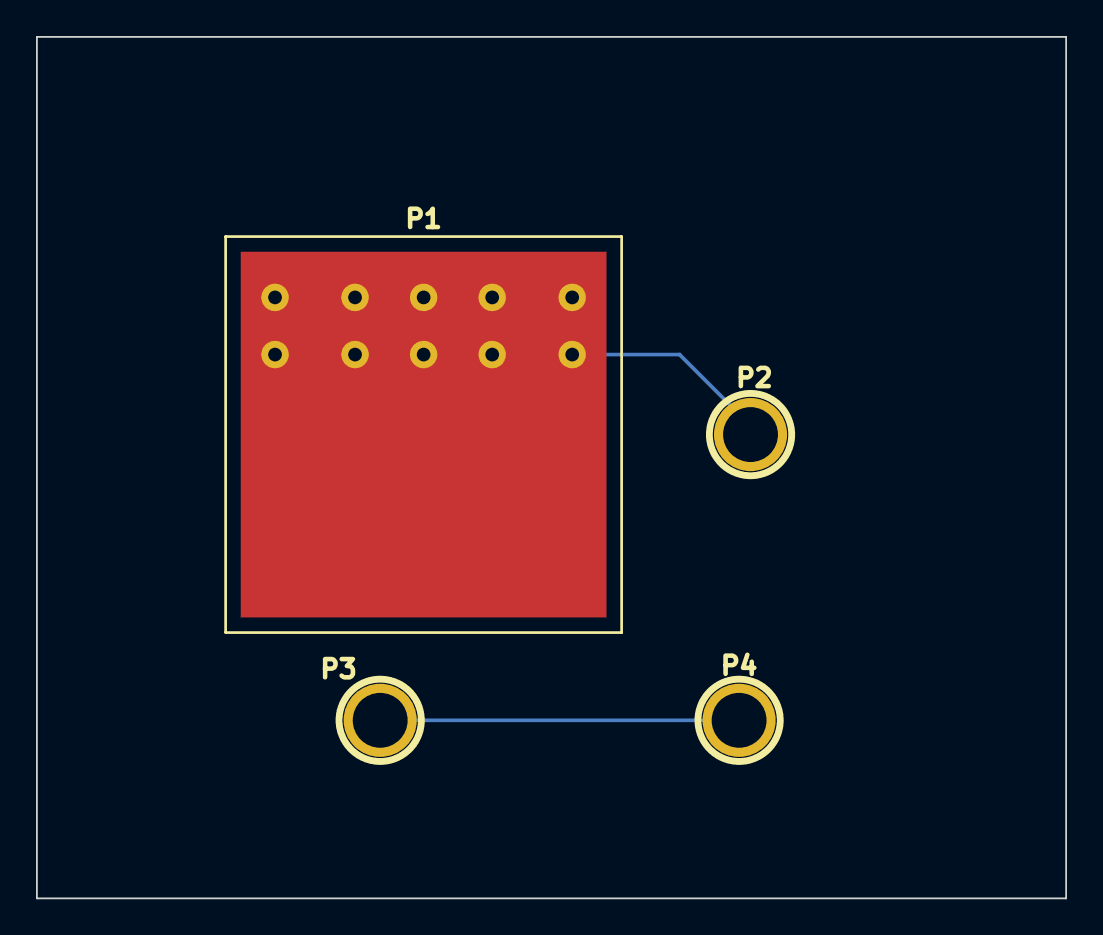
[picture p39: board test_pads_inside_pads.kicad_pcb from above]

Board: 2 copper layers, 57.2 x 47.9 mm, 4 parts (0 on the bottom side), 2 nets.
