jesseseay/kicad_lib/Wingate kicad/demos/interf_u/interf_u.kicad_pcb

## KiCad design Wingate kicad/demos/interf_u/interf_u.kicad_pcb (continued)

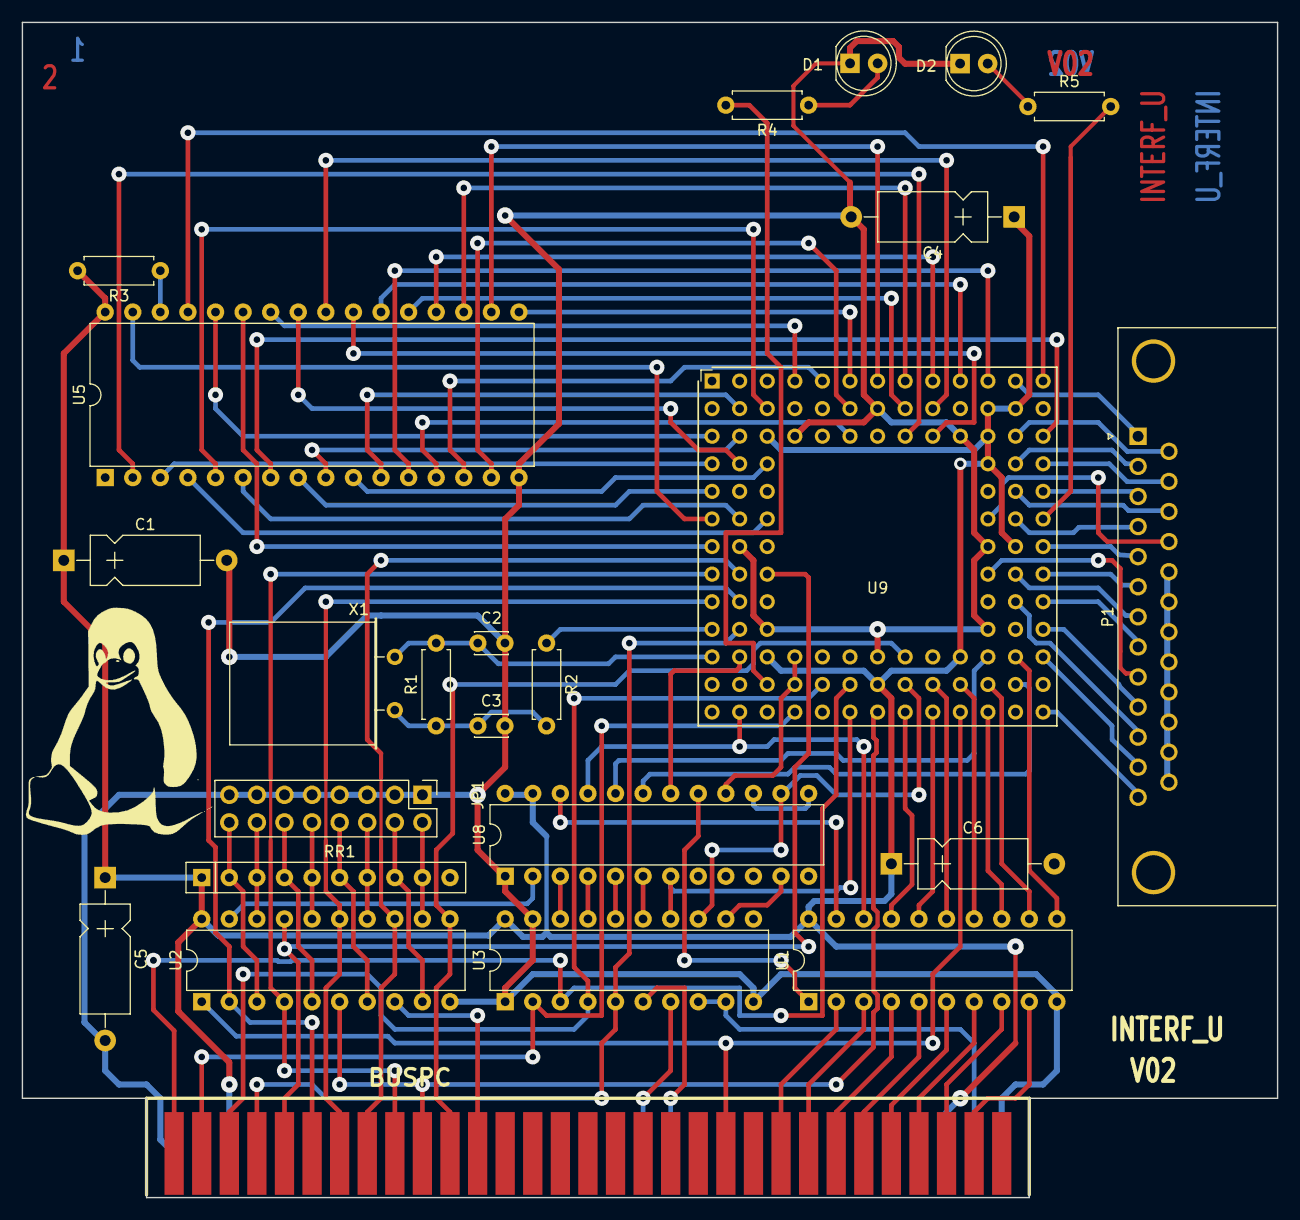
[picture p43: board interf_u.kicad_pcb from above]

Board: 2 copper layers, 115.6 x 108.2 mm, 25 parts (0 on the bottom side), 110 nets.

Other parts of the board:
G1: Tux; LOGO
