jesseseay/kicad_lib/(commit log)

2022-06-09 kicad migration github
2022-09-02 audio jack2
    [APHB1608.step, Arduino_Fio.kicad_pcb, Arduino_Fio.kicad_sch, Arduino_Mega.kicad_pcb, Arduino_Mega.kicad_sch, Arduino_Micro.kicad_pcb, Arduino_Micro.kicad_sch, Arduino_Mini.kicad_pcb]
